naoto64/Candle-LED-Control-Unit/README.md

# 1/fゆらぎLEDキャンドルキット
1/f ゆらぎのリアルな炎をマイコン制御で再現した LED キャンドルキットです。

[製品ページ](https://naoto64.github.io/Candle-LED-Control-Unit/ "1/fゆらぎLEDキャンドルキット 製品ページ")

[取扱説明書](https://naoto64.github.io/Candle-LED-Control-Unit/ "1/fゆらぎLEDキャンドルキット 取扱説明書")
