naoto64/Candle-LED-Control-Unit/candle-led.kicad_pcb

## KiCad design candle-led.kicad_pcb (2022-05-08)

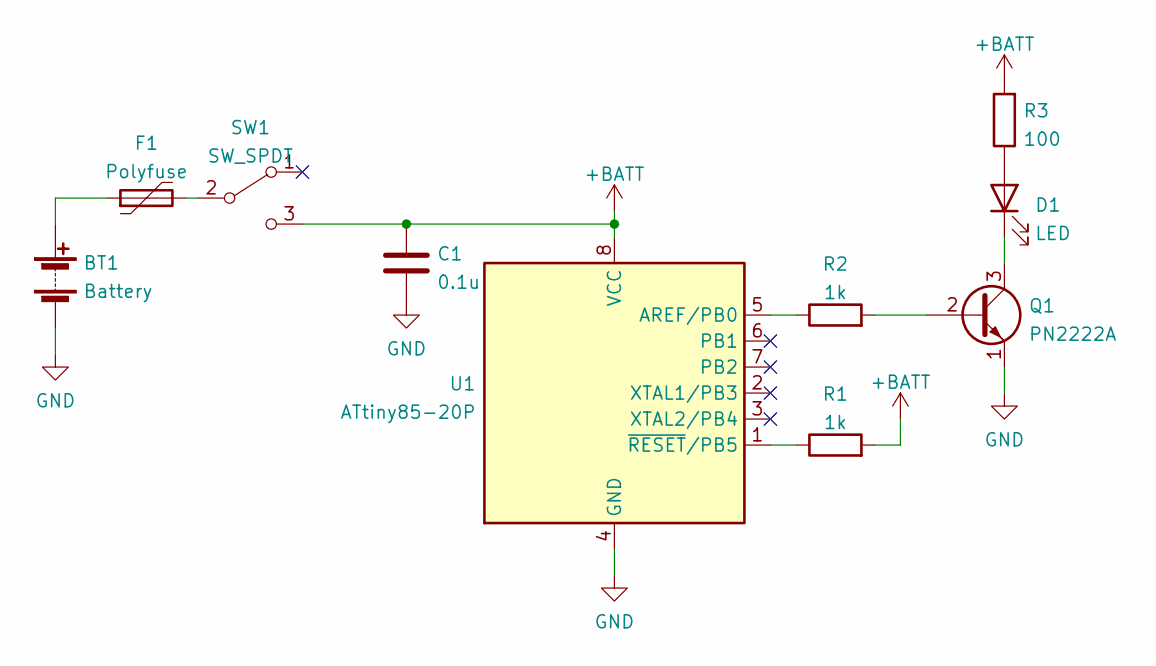
[picture p3: schematic candle-led.kicad_sch, Candle LED Control Unit]

Parts:
BT1: Battery; BatteryHolder_TruPower_BH-331P_3xAA
C1: 0.1u; C_Disc_D3.0mm_W1.6mm_P2.50mm
D1: LED; LED_D3.0mm
F1: Polyfuse; Fuse_Bourns_MF-RHT050
Q1: PN2222A; TO-92_Inline_Wide
R1, R2: 1k; R_Axial_DIN0204_L3.6mm_D1.6mm_P2.54mm_Vertical
R3: 100; R_Axial_DIN0204_L3.6mm_D1.6mm_P2.54mm_Vertical
SW1: SW_SPDT; PinHeader_1x03_P2.54mm_Vertical
U1: ATtiny85-20P; DIP-8_W7.62mm_Socket

Connections:
+BATT: C1.1, R1.2, R3.2, SW1.3 (C), U1.8 (VCC)
GND: BT1.2 (-), C1.2, Q1.1 (E), U1.4 (GND)
unnamed: BT1.1 (+), F1.1
unnamed: D1.1 (K), Q1.3 (C)
unnamed: D1.2 (A), R3.1
unnamed: F1.2, SW1.2 (B)
unnamed: Q1.2 (B), R2.2
unnamed: R1.1, U1.1 (~RESET/PB5)
unnamed: R2.1, U1.5 (AREF/PB0)

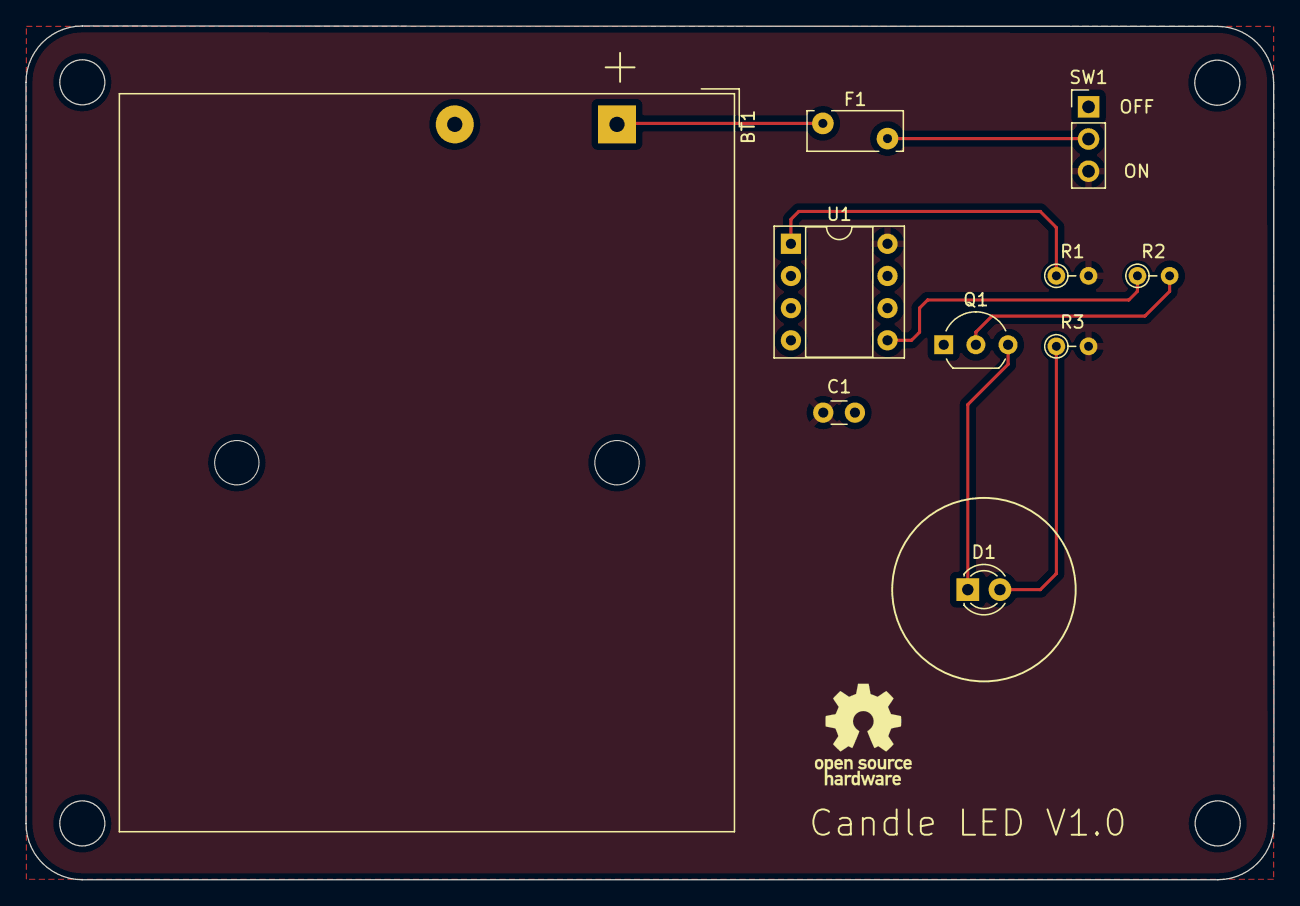
[picture p4: board candle-led.kicad_pcb from above]

Board: 2 copper layers, 98.5 x 67.4 mm, 10 parts (0 on the bottom side), 9 nets.
